GiorgioSW/godong/cabinet/doc/README.md

## Sub Folder ini berisikan dokumentasi hardware dari panel Godong
- skema/board di desain menggunakan autodesk eagle (v9 keatas)
- terdapat file PDF untuk skema/board dan keterangannya, lihat `hardware/Godhong_Project_Documentation_FULL.pdf`

## TODO untuk hardware
- tds meter masih DIY, sehingga sangat tidak stabil. ada beberapa referensi hardware dipasaran(grafity) namun hanya dapat mengukur dari rentang ppm 0 hingga 1000 saja s(Godong memerlukan rentang 0-2000ppm). terdapat artikel yang cukup bagus untuk digunakan sebagai referensi desain TDS meter kedepannya 'https://thecavepearlproject.org/2017/08/12/measuring-electrical-conductivity-with-an-arduino-part1-overview/'
- kabel penghubung dari main board ke modul relay hanyalah kabel pelangi biasa, yang seharusnya kabel IDC 16x2. ganti ke kabel IDC bila sudah ada.
