GiorgioSW/godong/cabinet/doc/schematic/OUTPUT/Image/BoardKeteranganLengkap.png

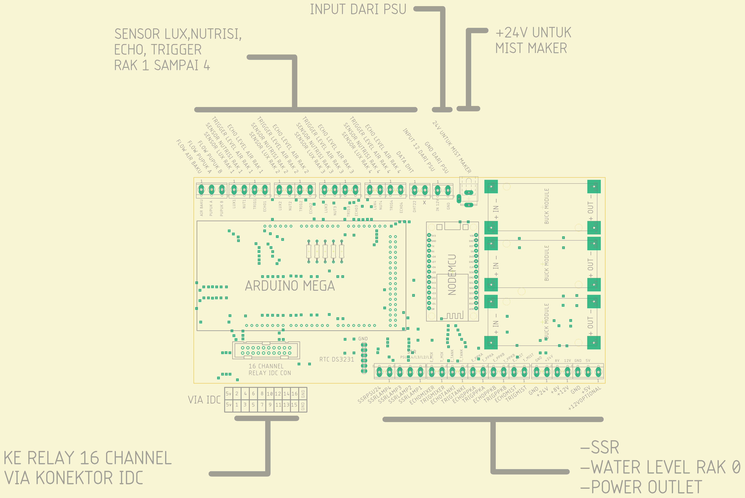
cabinet/doc/schematic/OUTPUT/Image/BoardKeteranganLengkap.png
