GiorgioSW/godong/cabinet/doc/schematic/OUTPUT/Image/BoardView.png

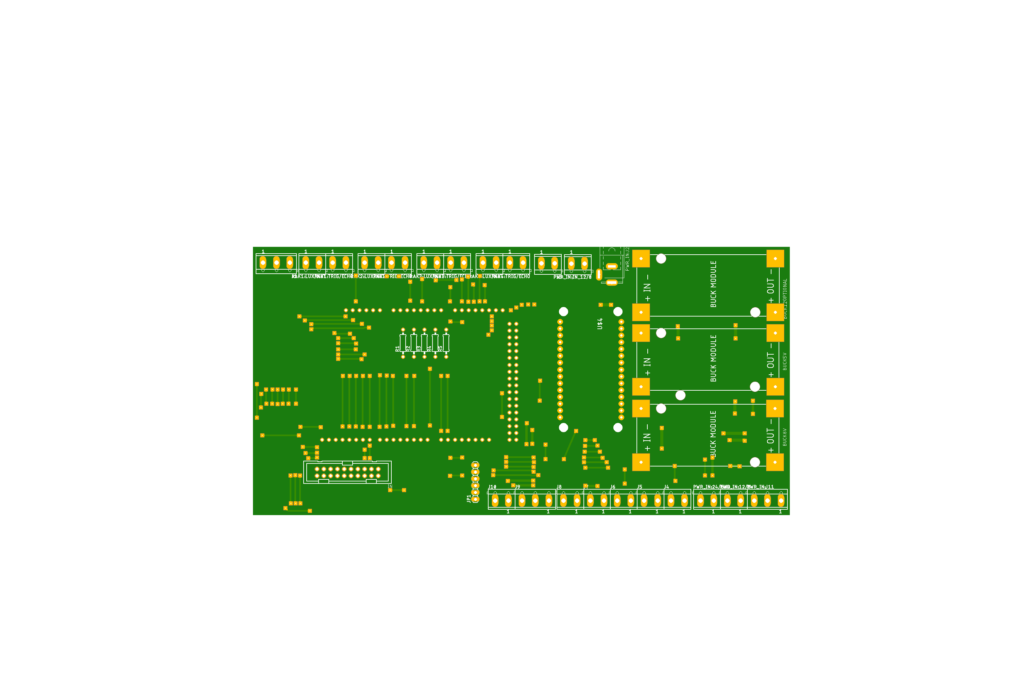
cabinet/doc/schematic/OUTPUT/Image/BoardView.png
