GiorgioSW/godong/cabinet/doc/hardware/Godhong_Project_Documentation_FULL.pdf

400.00

# TATA LETAK PANEL

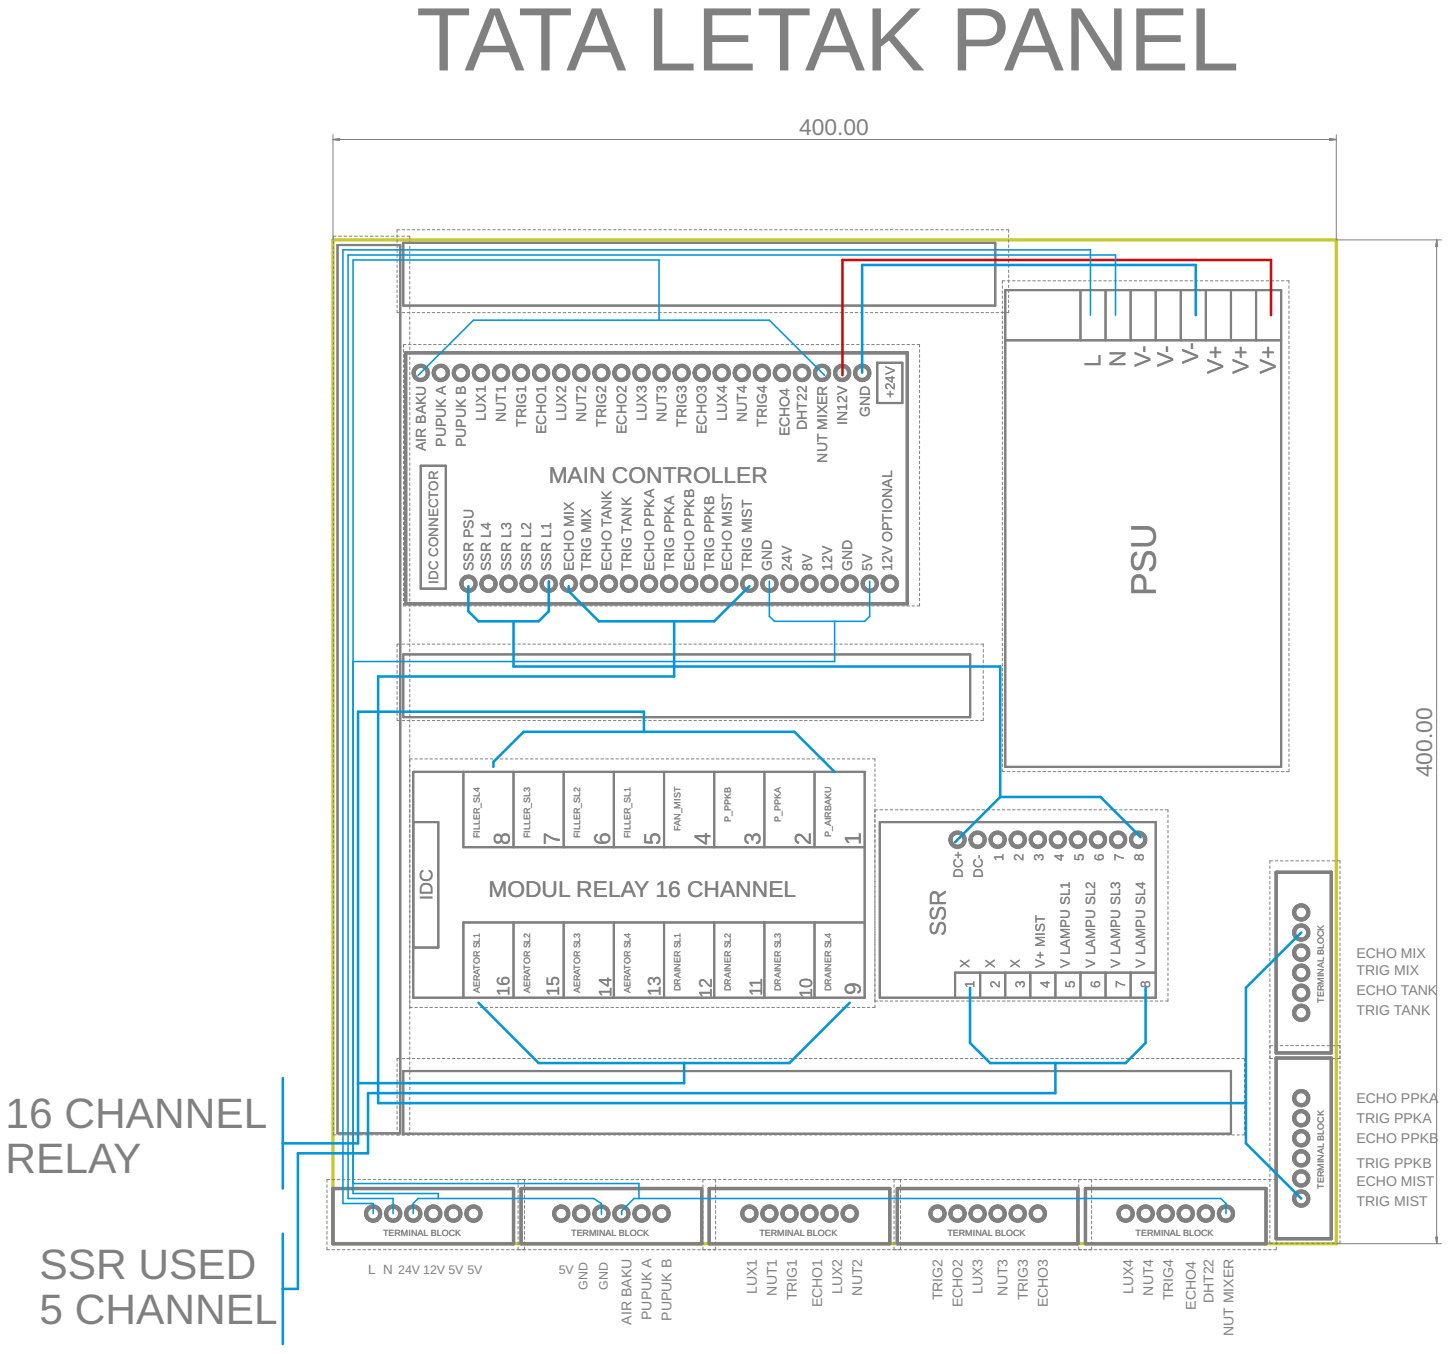
[picture p20: page 1]
TERMINAL BLOCK; MAIN CONTROLLER; AIR BAKU; PUPUK A; PUPUK B; LUX1 NUT1 TRIG1 ECHO1; LUX2 NUT2 TRIG2 ECHO2; LUX3 NUT3 TRIG3 ECHO3; LUX4 NUT4 TRIG4 ECHO4 DHT22 NUT MIXER; IN12V GND; SSR PSU; TRIG MIX; ECHO TANK; TRIG TANK; ECHO PPKA; TRIG PPKA; ECHO PPKB; TRIG PPKB; ECHO MIST; 12V GND; 12V OPTIONAL; IDC CONNECTOR; IDC; P_AIRBAKU; P_PPKA; P_PPKB; FAN_MIST; FILLER_SL1; FILLER_SL2; FILLER_SL3; FILLER_SL4; AERATOR SL4; AERATOR SL3; AERATOR SL2; AERATOR SL1; GND; TRIG PPKB ECHO MIST; 16 CHANNEL RELAY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

SSR L4 SSR L3 SSR L2 SSR L1 ECHO MIX

SSR L4 SSR L3 SSR L1 ECHO MIX

TRIG MIST GND

8 V LAMPU SL4 V LAMPU SL3 V LAMPU SL2 V LAMPU SL1 V+ MIST

MODUL RELAY 16 CHANNEL

DUL RELAY 16 CHANNEL

DRAINER SL4 DRAINER SL3 DRAINER SL2 DRAINER SL1

TERMINAL BLOCK ECHO MIX

TERMINAL BLOCK

TRIG MIST GN

# WATER LEVEL ULTRASONIC

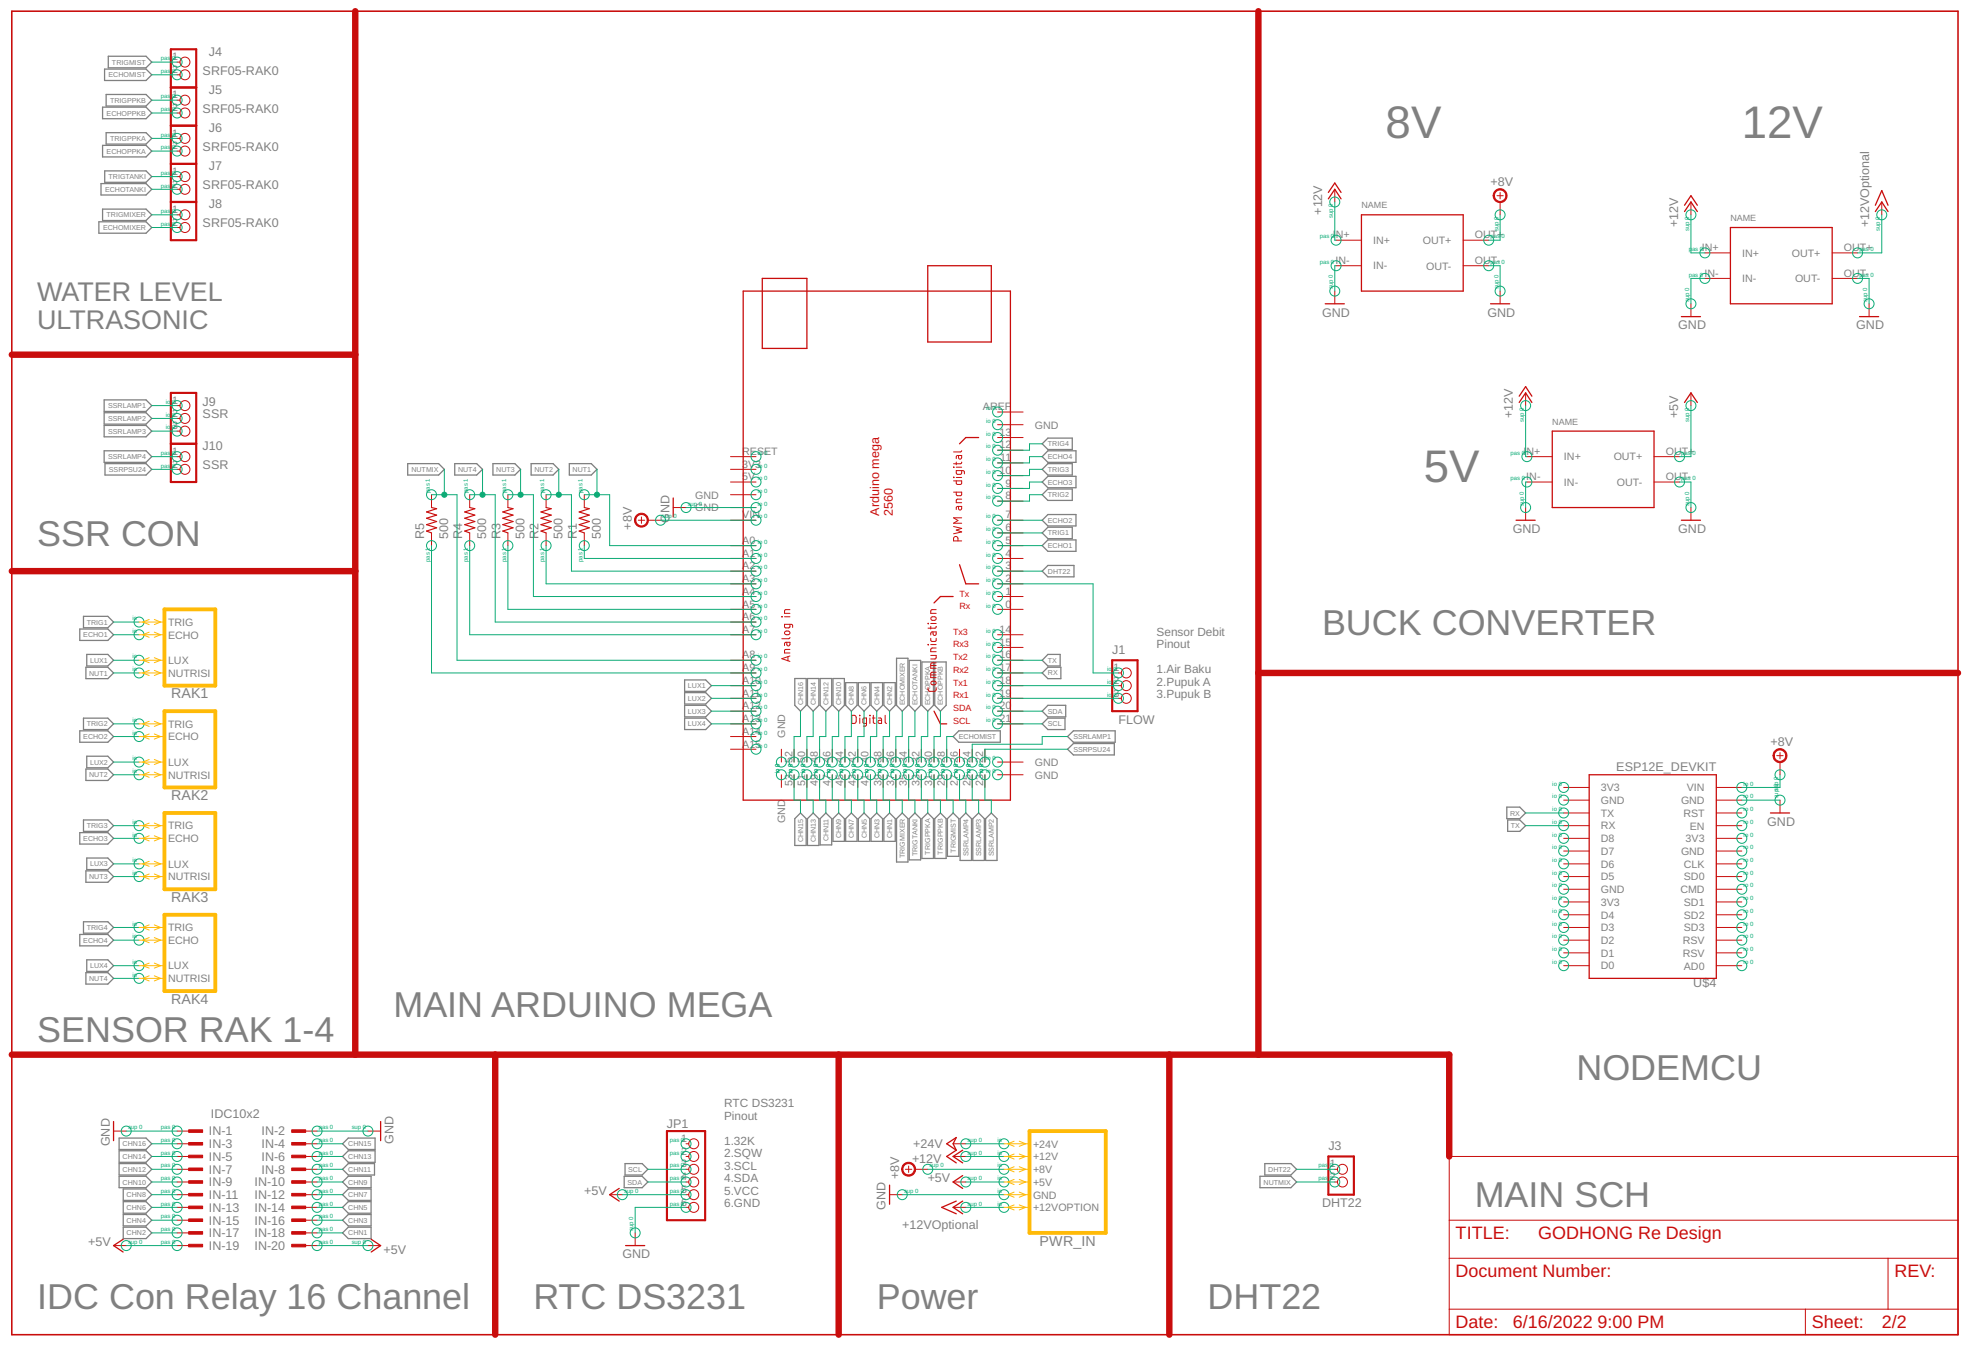
[picture p21: page 2]

Sensor Debit Pinout 1.Air Baku

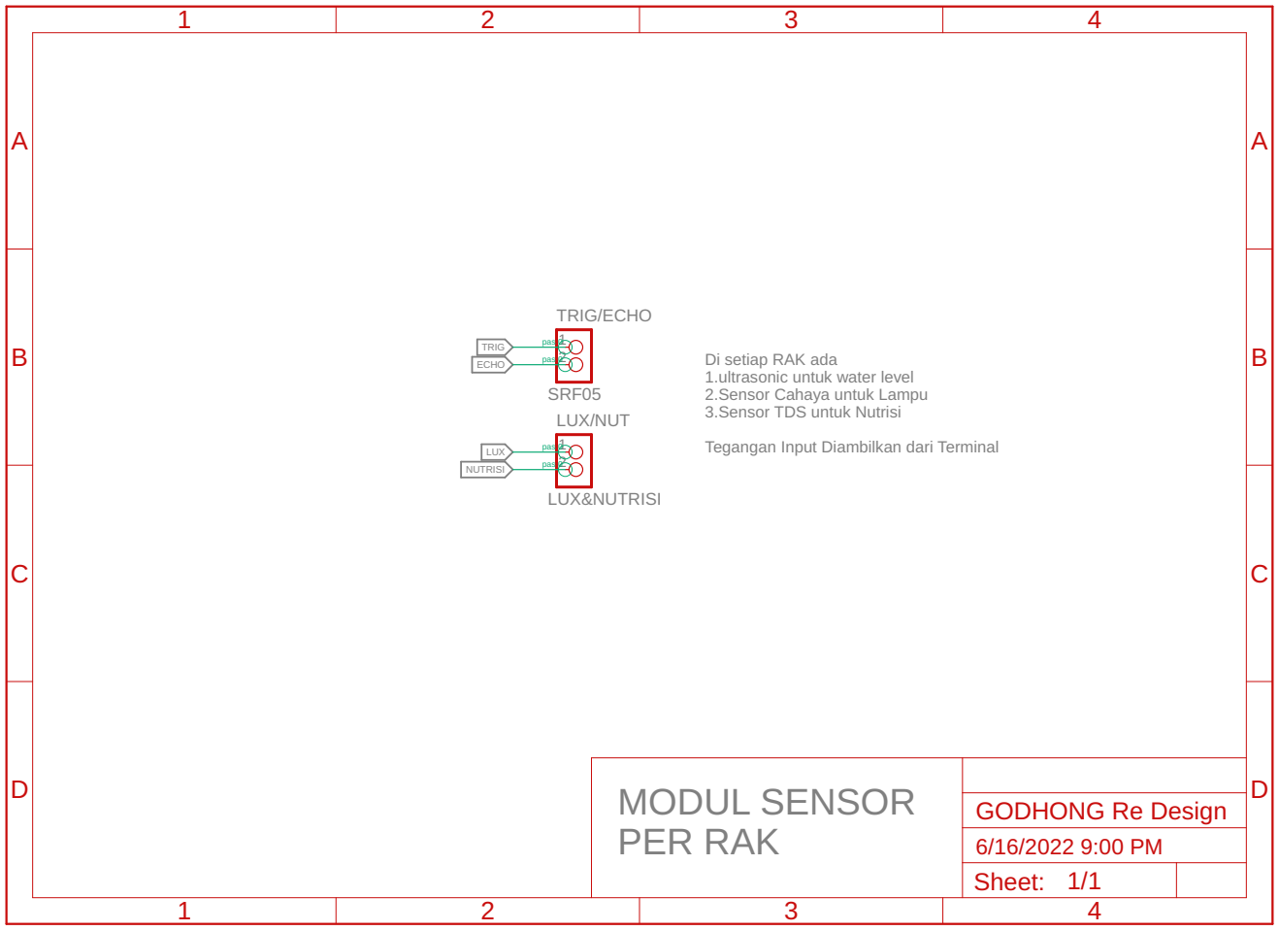
[picture p22: figure]
Di setiap RAK ada 1.ultrasonic untuk water level 2.Sensor Cahaya untuk Lampu 3.Sensor TDS untuk Nutrisi; Tegangan Input Diambilkan dari Terminal; MODUL SENSOR PER RAK; SRF05; LUX&NUTRISI; 2TRIG/ECHO; 2LUX/NUT; TRIG; ECHO; LUX NUTRISI; Sheet: 1/1; GODHONG Re Design; pas

1 | 2 | 3 | 4

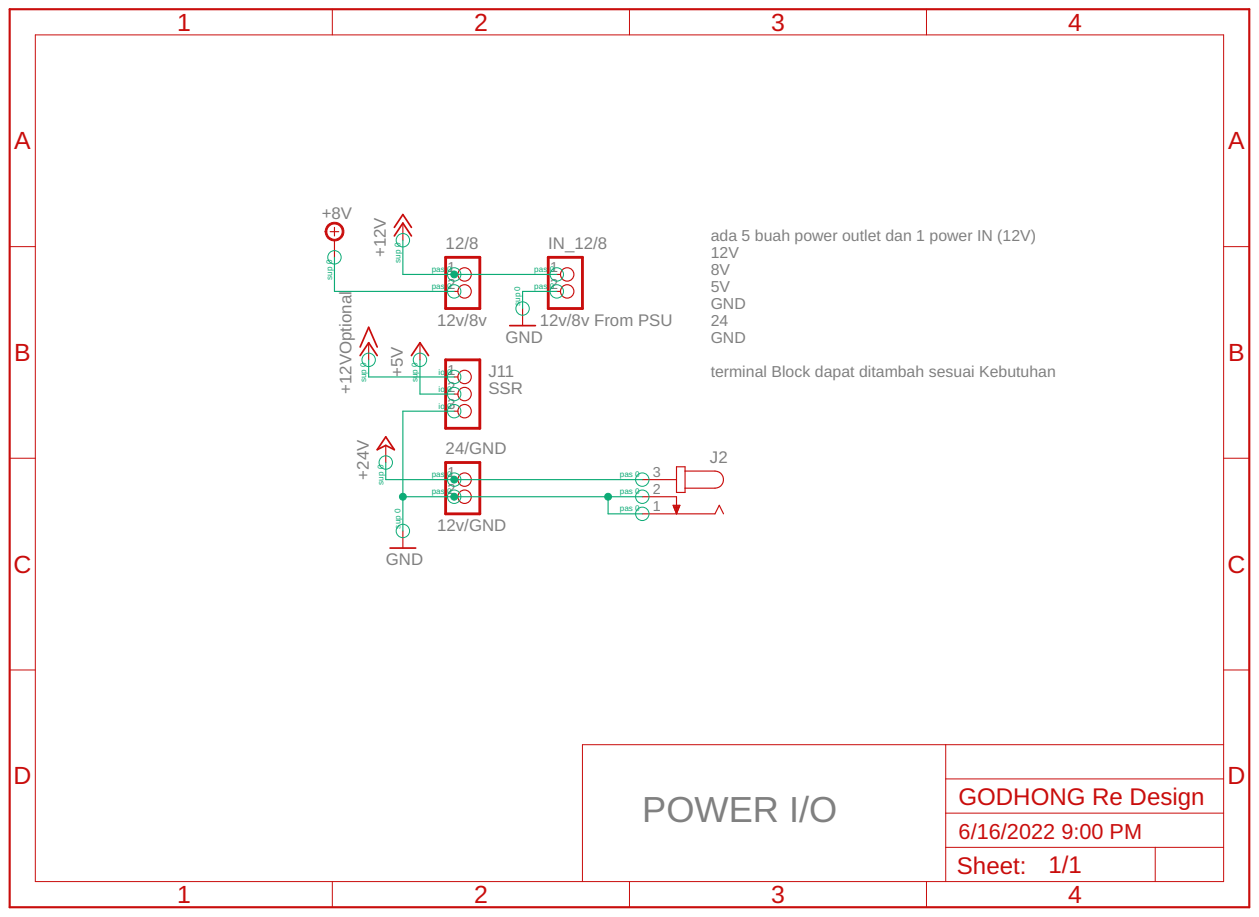
[picture p23: page 4]
ada 5 buah power outlet dan 1 power IN (12V) 12V 8V 5V GND 24 GND; 12v/8v ⁺¹²V; GND; 12v/GND; 12v/8v From PSU GND; +SSR; Optional 1; 224/GND; pas; sup 0; pas 0

terminal Block dapat ditambah sesuai Kebutuhan

GODHONG Re Design

POWER I/O

Sheet: 1/1

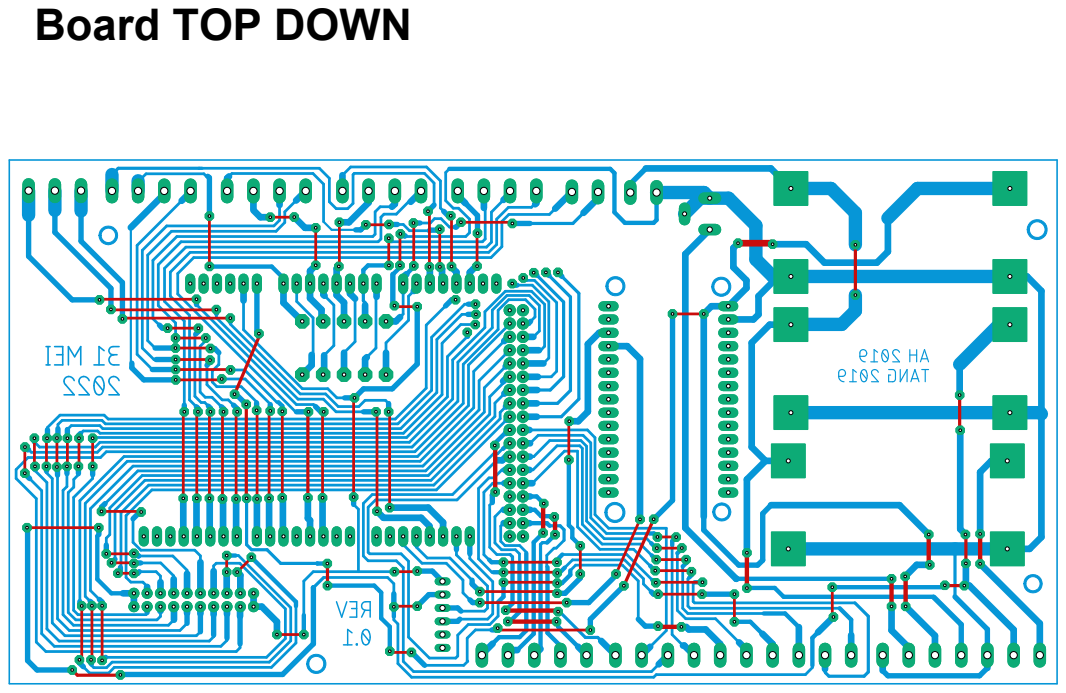
[picture p24: page 5]

Board TOP DOWN

# Board Detail

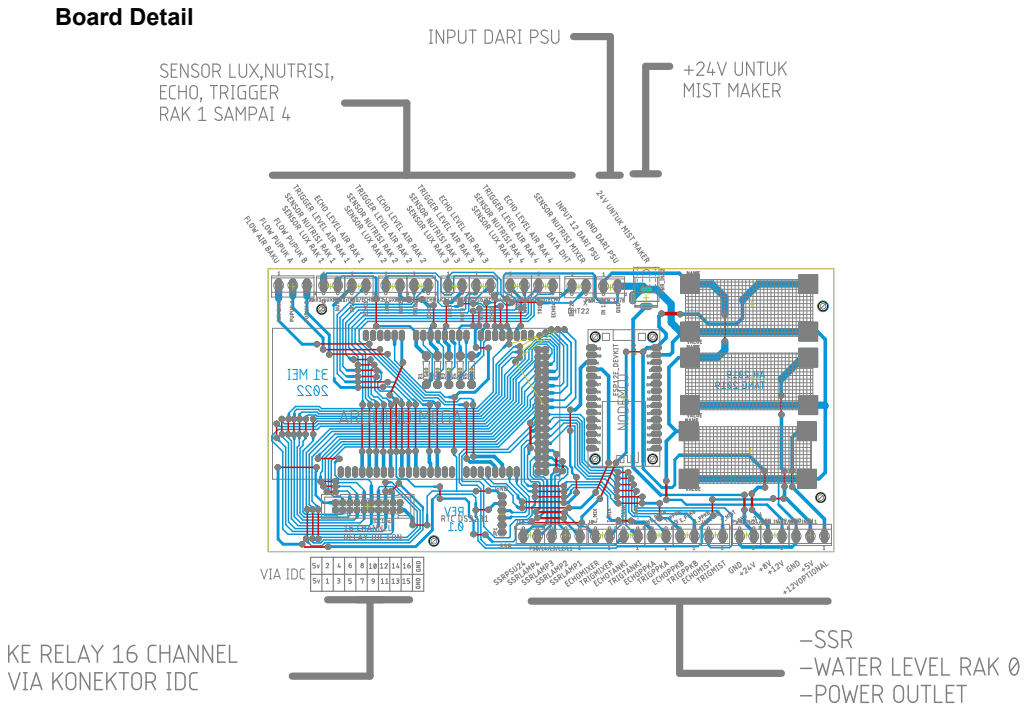
[picture p25: page 6]

# Jalur Rangkaian

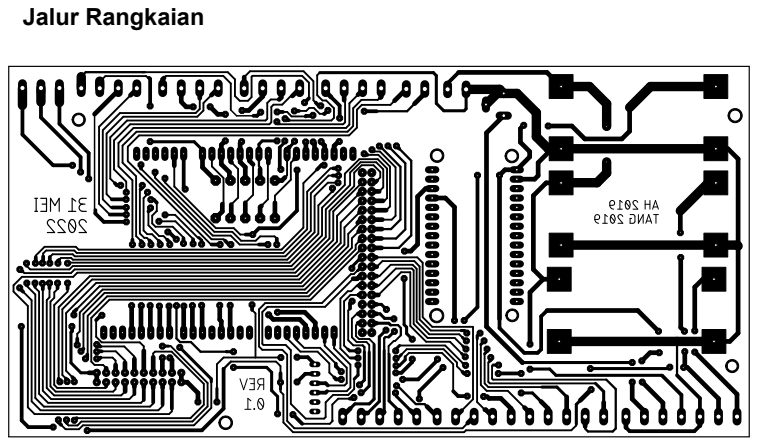
[picture p26: page 7]

# Silk Screen

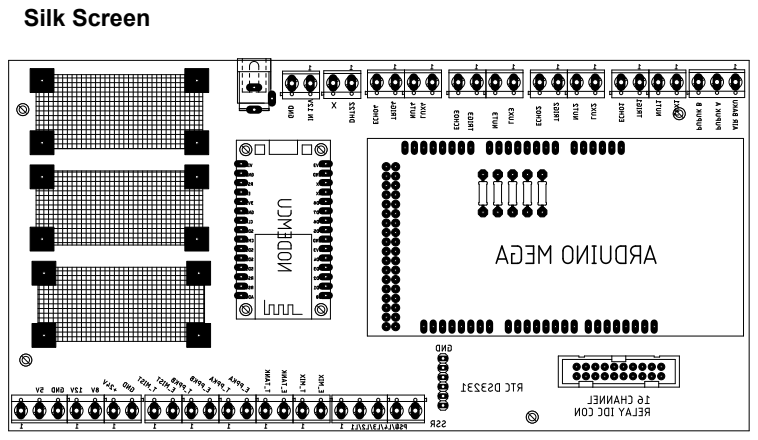
[picture p27: page 8]
