GiorgioSW/godong/cabinet/doc/schematic/OUTPUT/PDF/Godhong_Project_Documentation.pdf

SSR L4 SSR L3 SSR L2 SSR L1 ECHO MIX

SSR L4 SSR L3 SSR L1 ECHO MIX

8 V LAMPU SL4 V LAMPU SL3 V LAMPU SL2 V LAMPU SL1 V+ MIST

DRAINER SL4 DRAINER SL3 DRAINER SL2 DRAINER SL1

TERMINAL BLOCK ECHO MIX

TERMINAL BLOCK


Sensor Debit Pinout 1.Air Baku

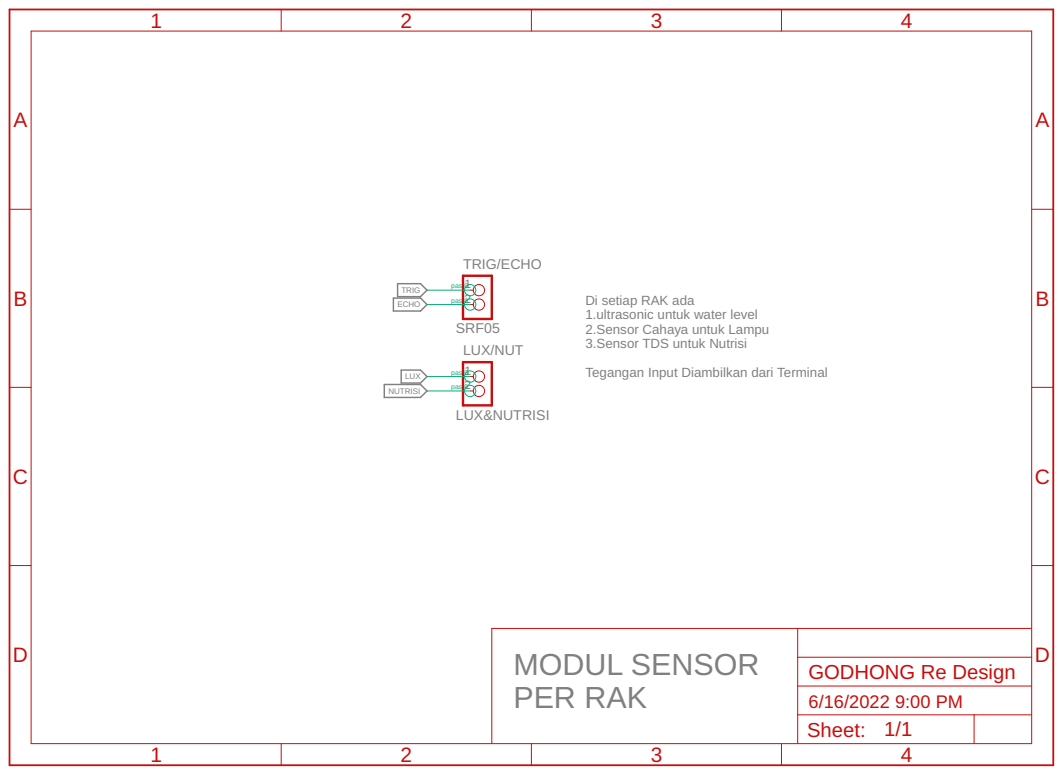
[picture p28: page 3]
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

Tegangan Input Diambilkan dari Terminal

MODUL SENSOR PER RAK

Sheet: 1/1


terminal Block dapat ditambah sesuai Kebutuhan

POWER I/O

Sheet: 1/1
