GiorgioSW/godong/cabinet/doc/schematic/OUTPUT/PDF/Godong Schematic.pdf

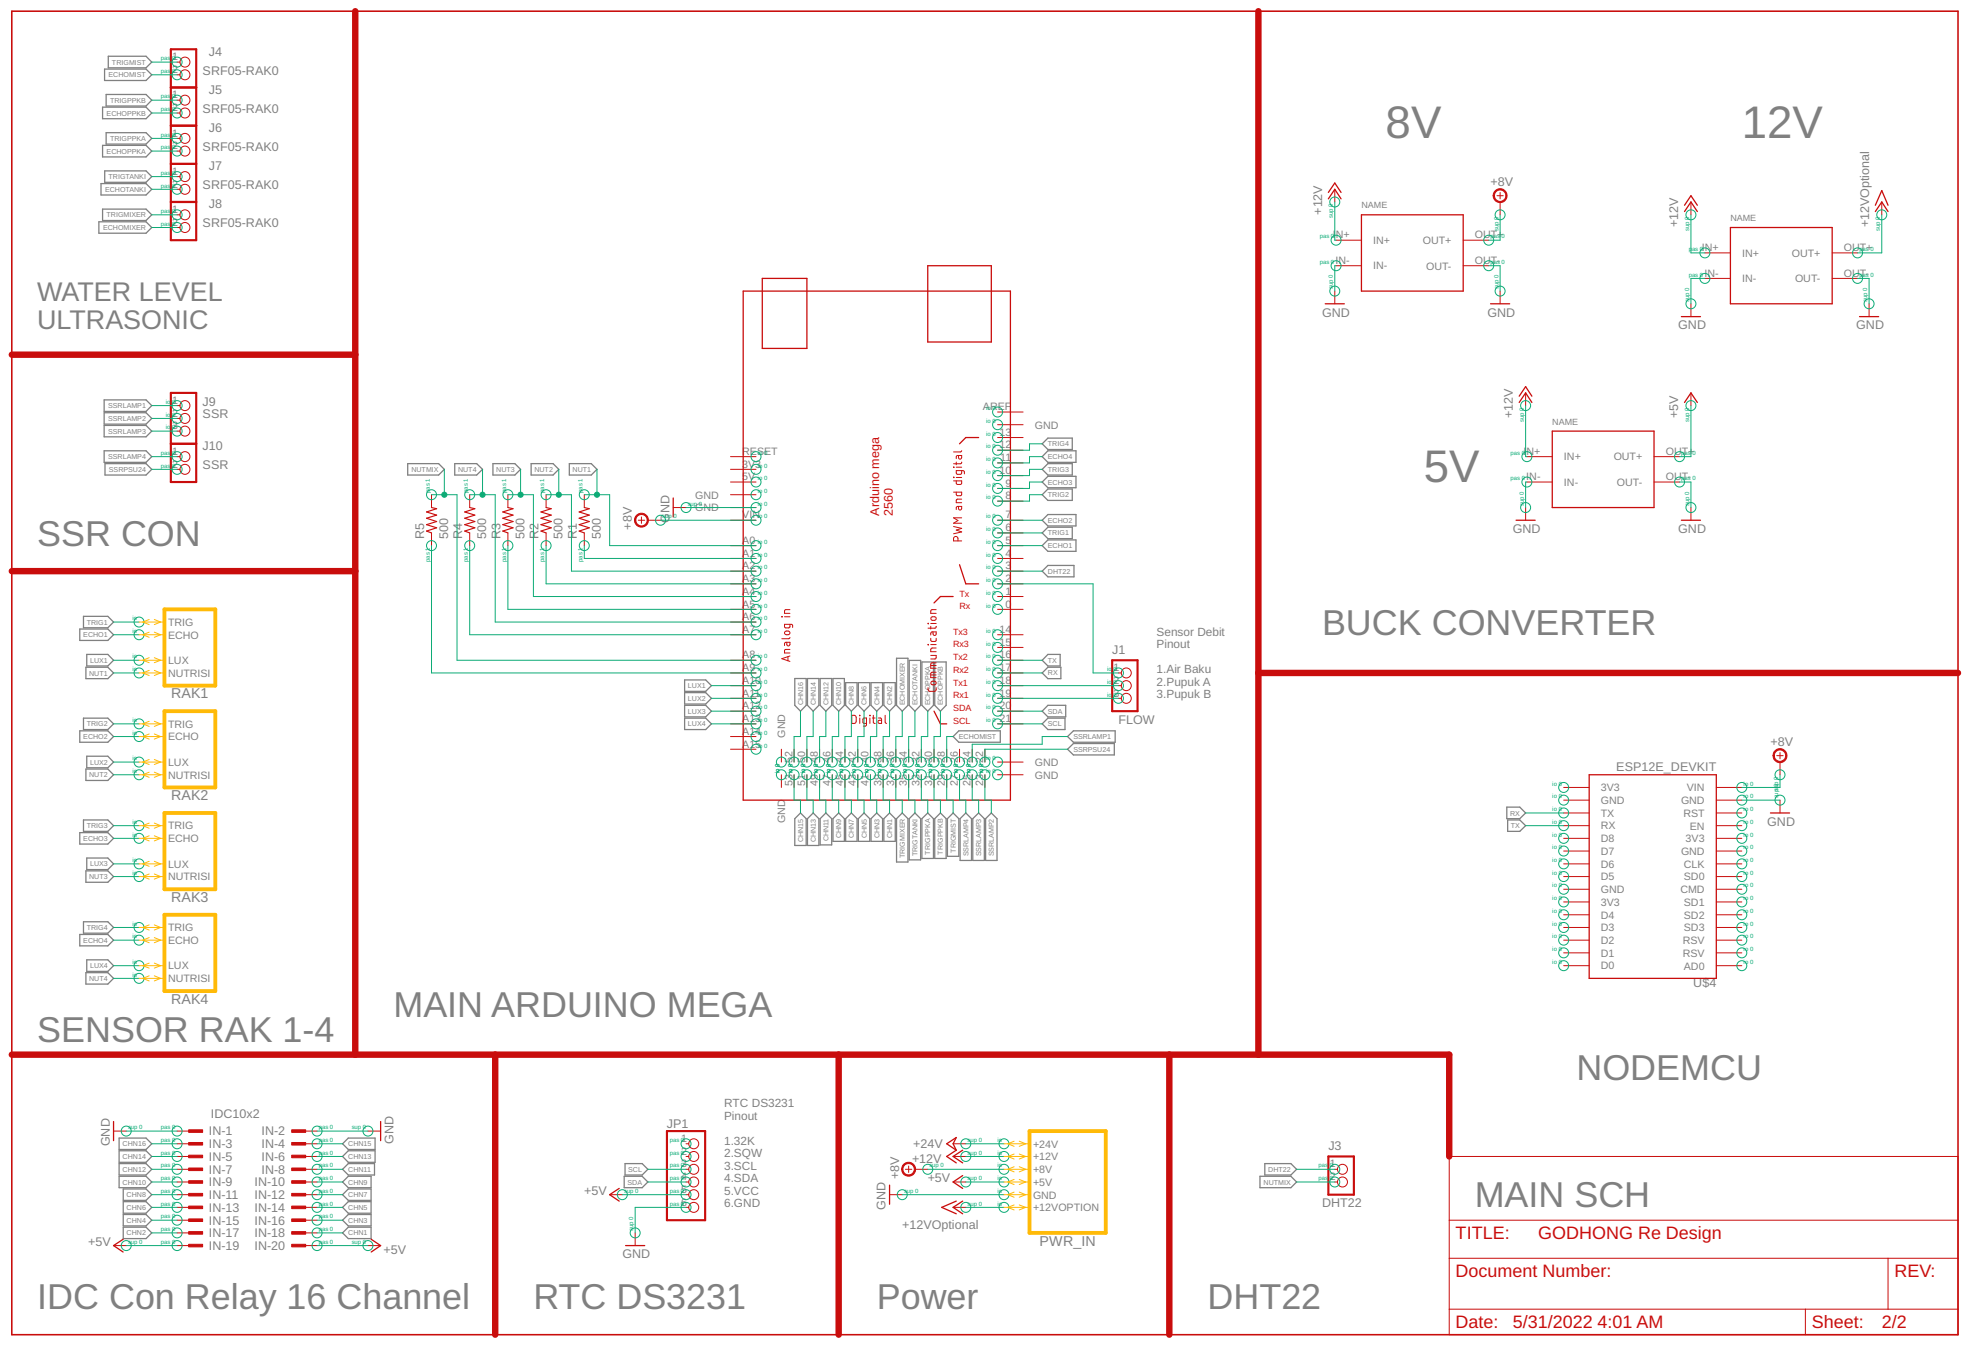
[picture p29: page 2]

Sensor Debit Pinout 1.Air Baku

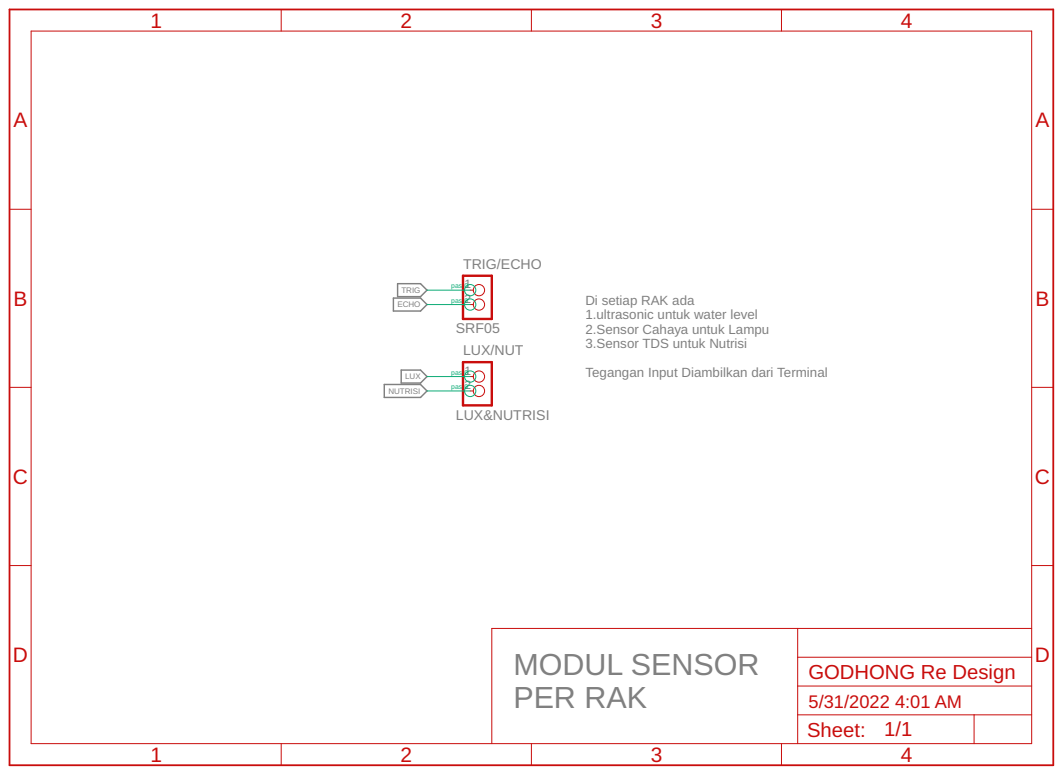
[picture p30: page 3]

Di setiap RAK ada
1.ultrasonic untuk water level
2.Sensor Cahaya untuk Lampu
3.Sensor TDS untuk Nutrisi

Tegangan Input Diambilkan dari Terminal

MODUL SENSOR PER RAK

Sheet: 1/1

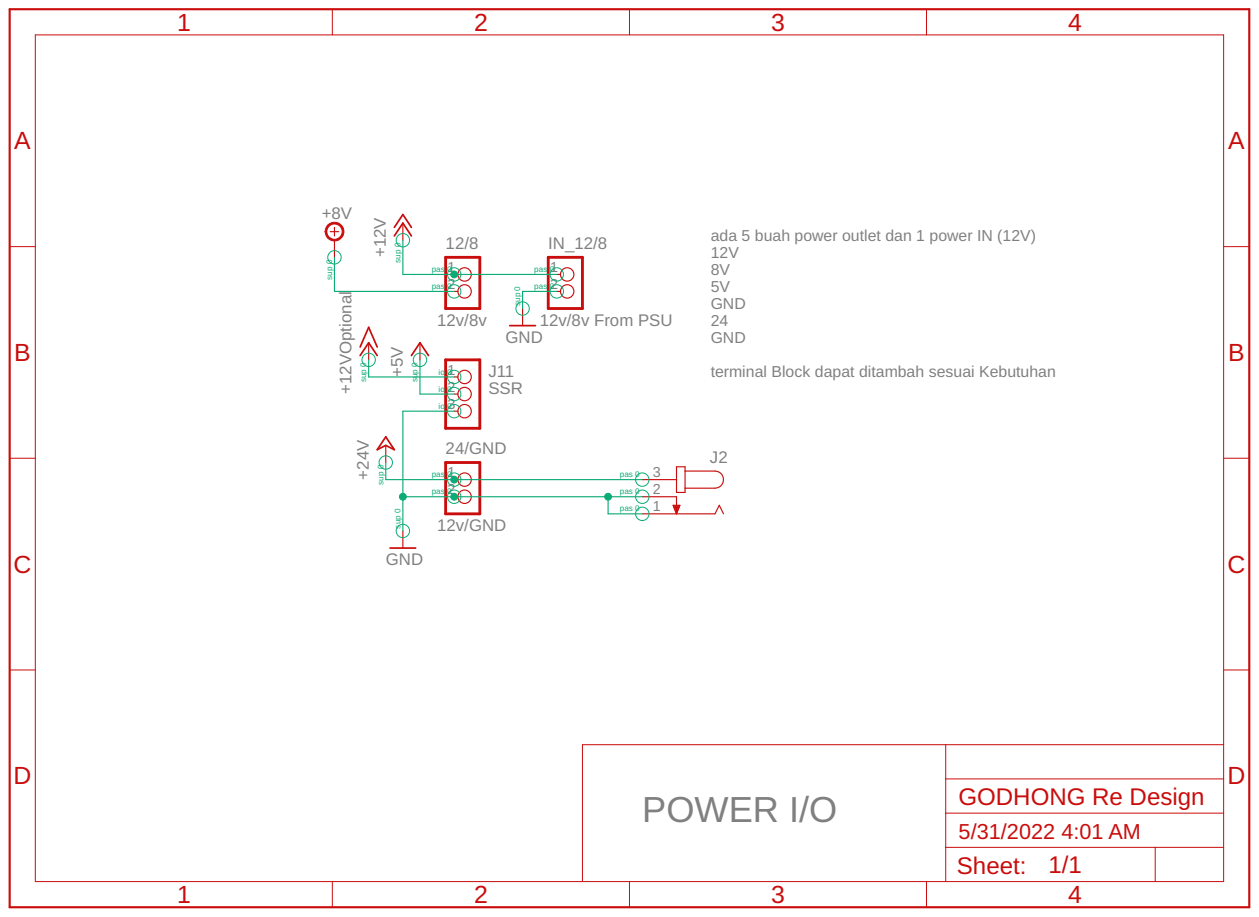
[picture p31: page 4]

terminal Block dapat ditambah sesuai Kebutuhan

POWER I/O

Sheet: 1/1
