GiorgioSW/godong/cabinet/doc/schematic/OUTPUT/PDF/Godong Board Top Down.pdf

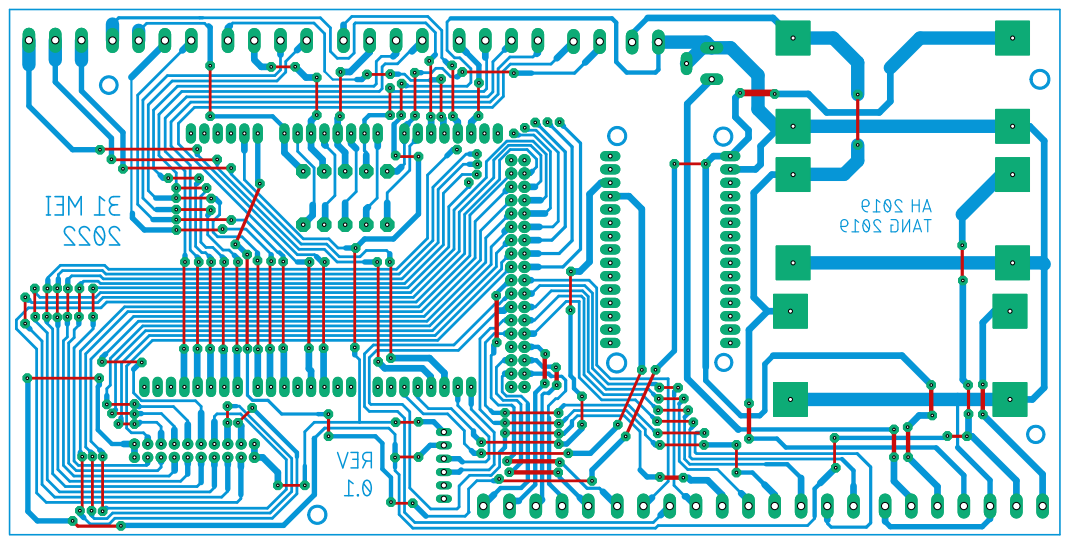
[picture p32: page 1]
