GiorgioSW/godong/cabinet/doc/schematic/OUTPUT/PDF/Godong Keterangan Lengkap.pdf

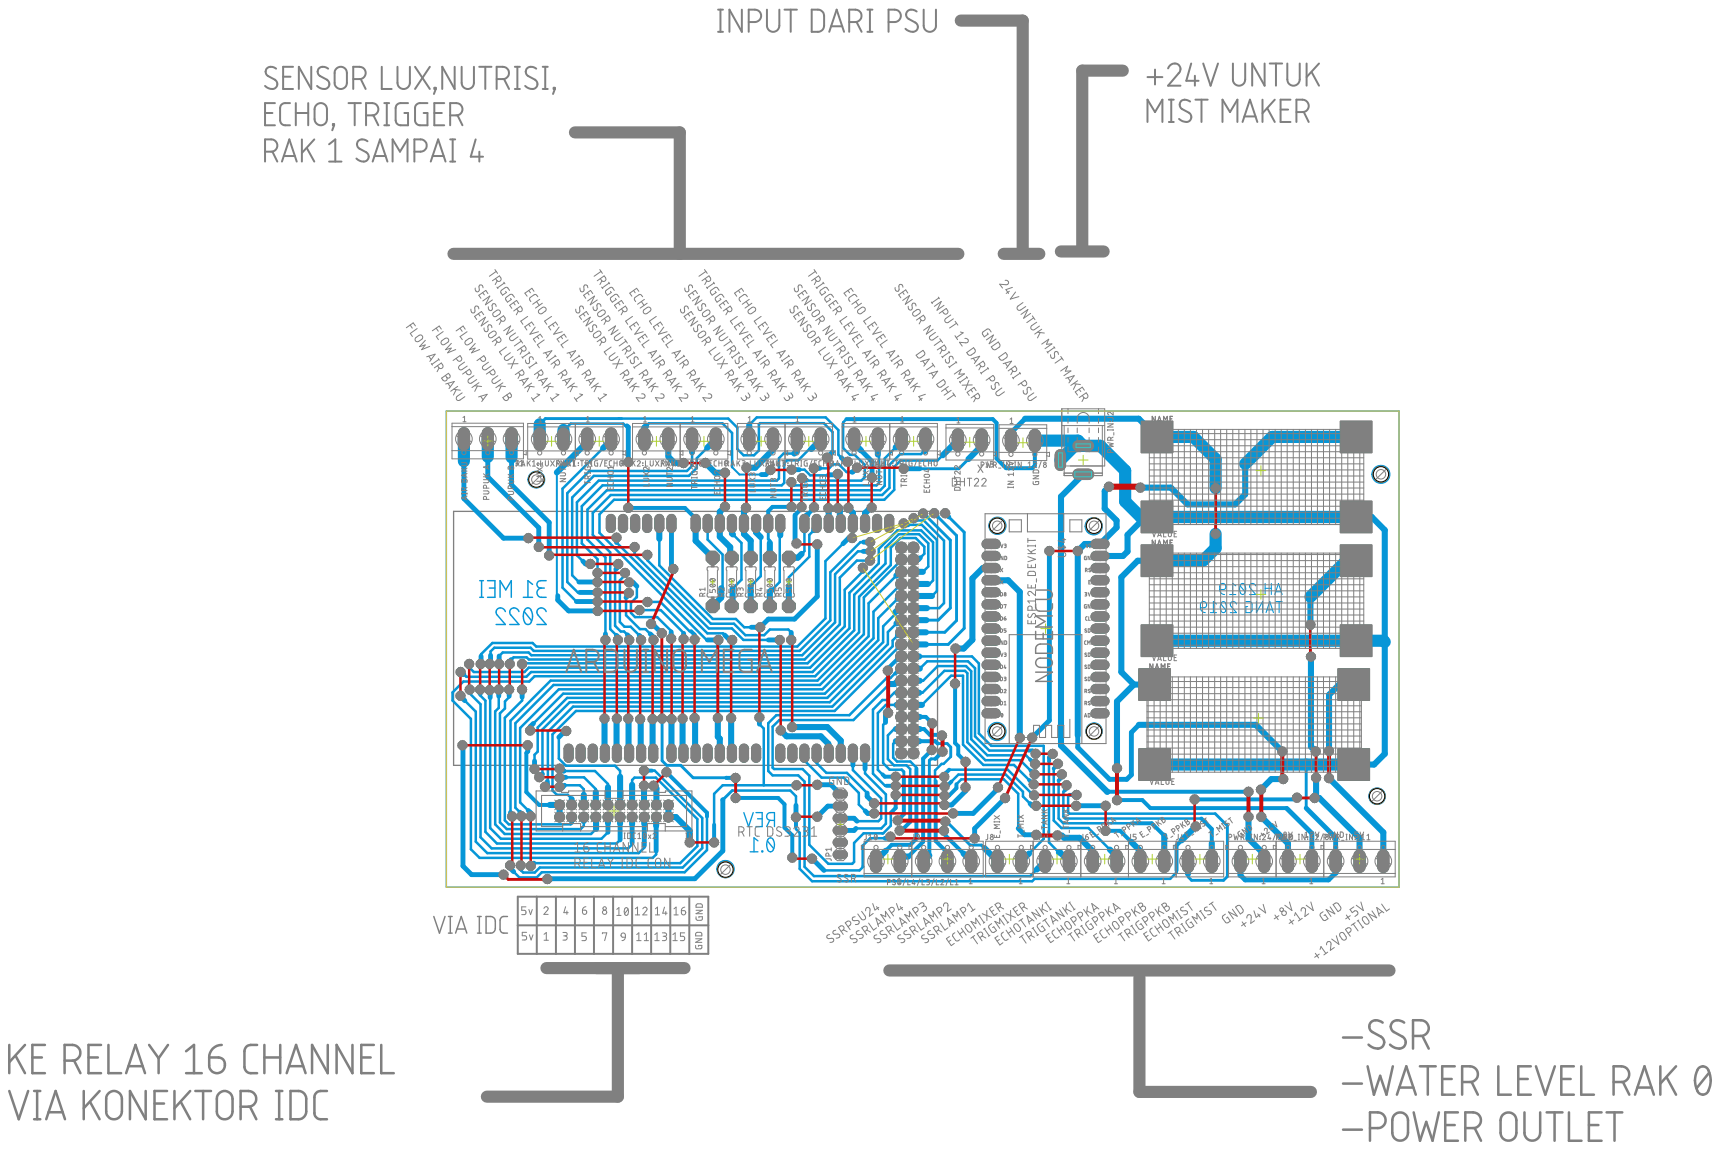
[picture p33: page 1]
