GiorgioSW/godong/cabinet/doc/schematic/OUTPUT/PDF/JALUR PCB - GODHONG Re Design.pdf

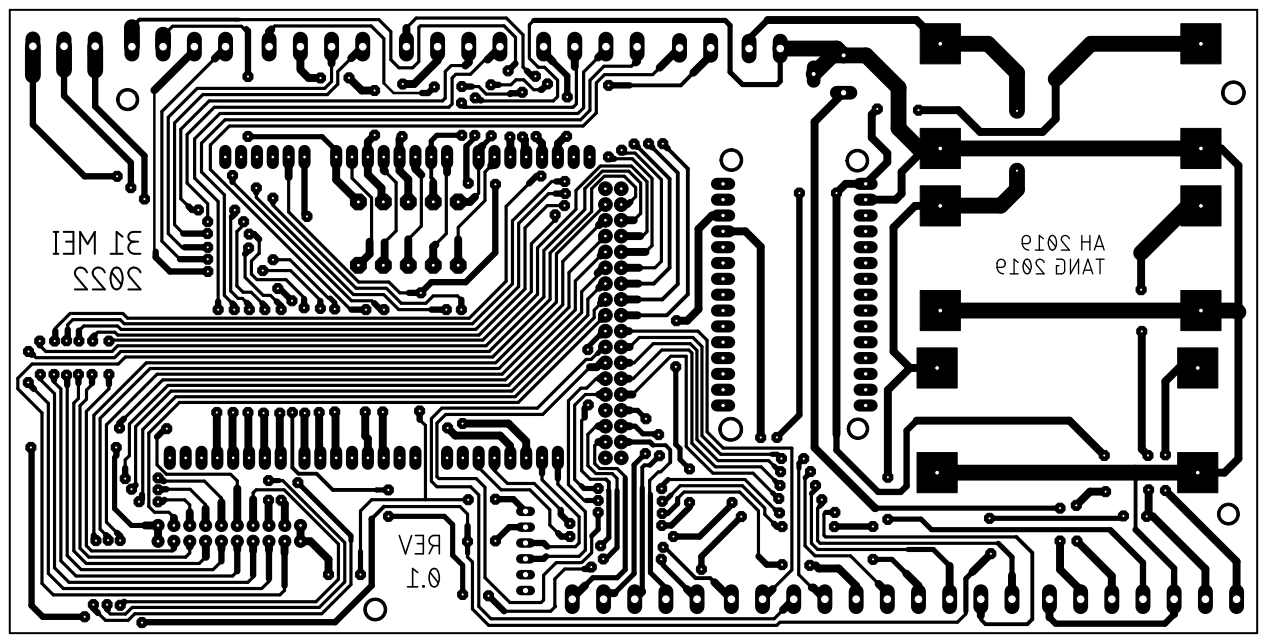
[picture p34: page 1]
