GiorgioSW/godong/cabinet/doc/schematic/OUTPUT/PDF/Silk Screen - GODHONG Re Design.pdf

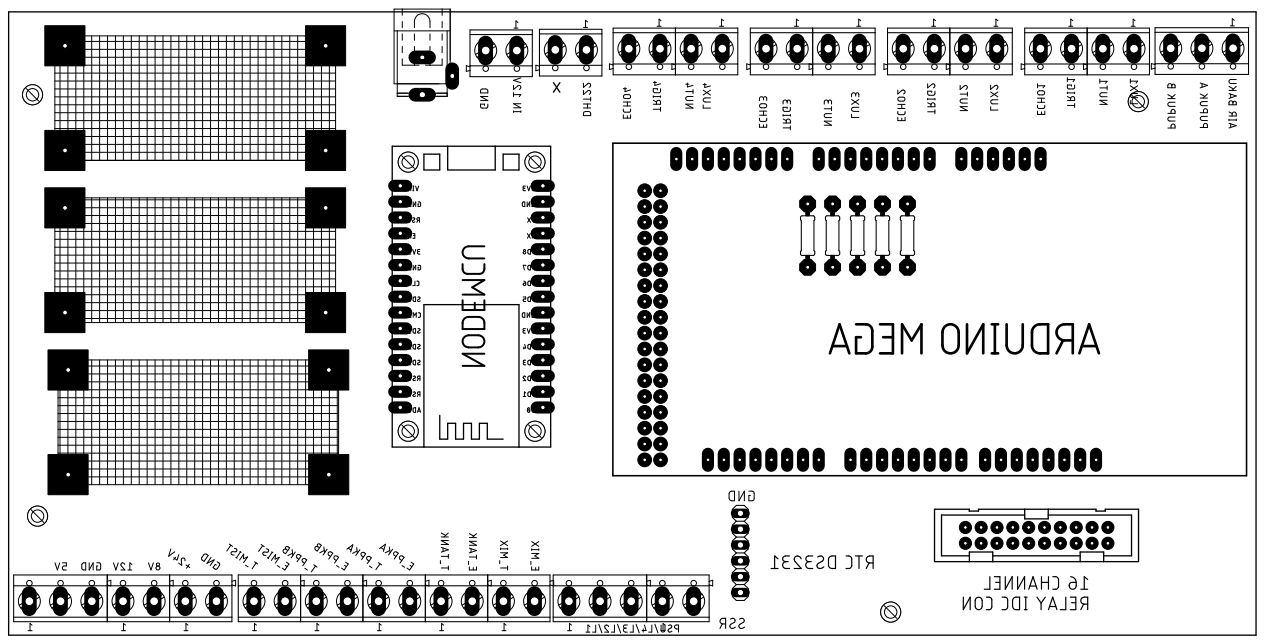
[picture p35: page 1]
