GiorgioSW/godong/cabinet/doc/schematic/GODHONG Re Design.brd

## EAGLE design cabinet/doc/schematic/GODHONG Re Design.brd (2022-09-20)

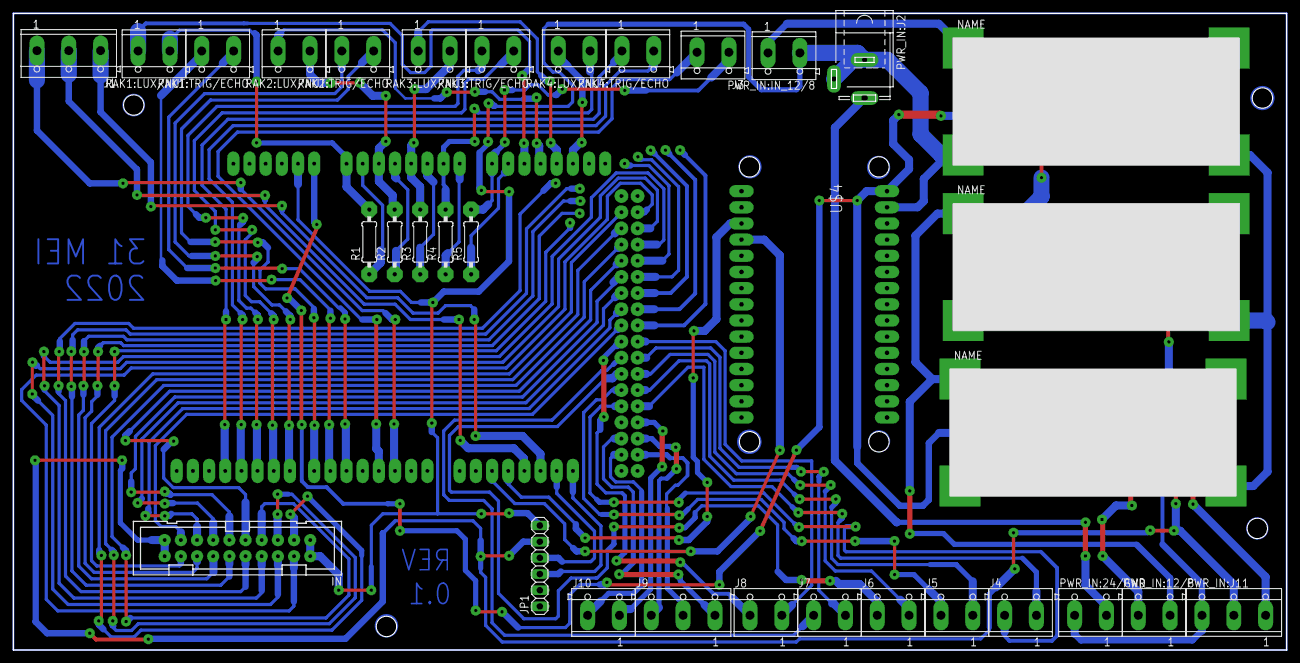
[picture p36: board GODHONG Re Design.brd from above]

Board: 2 copper layers, 200.0 x 100.0 mm, 34 parts (1 on the bottom side), 67 nets.

Parts:
5V: 5V; CP8-ADJ
8V: 8V; CP8-ADJ
12OPTION: 12Option; CP8-ADJ
IN: IDC10x2; PAK100/2500-20
J1, J9: Debit; TERMINAL_BLOCK_3P_5
J3, J4, J5, J6, J7, J8, J10: SRF05; TERMINAL_BLOCK_2P_5
JP1: 1X06
PWR_IN:12/8, PWR_IN:24/GND: SRF05; TERMINAL_BLOCK_2P_5
PWR_IN:IN_12/8: SRF05; TERMINAL_BLOCK_2P_5
PWR_IN:J2: SPC4078
PWR_IN:J11: Debit; TERMINAL_BLOCK_3P_5
R1, R2, R3, R4, R5: 500; 0207/10
RAK1:LUX/NUT, RAK1:TRIG/ECHO, RAK2:LUX/NUT, RAK2:TRIG/ECHO, RAK3:LUX/NUT, RAK3:TRIG/ECHO, RAK4:LUX/NUT, RAK4:TRIG/ECHO: SRF05; TERMINAL_BLOCK_2P_5
U$1: MEGA_DEVICE; MEGAOUTLINE
U$4: ESP12E_DEVKIT

Connections:
+5V: 5V.OUT+, IN.19, IN.20, JP1.5, PWR_IN:J11.2
+8V: 8V.OUT+, PWR_IN:12/8.2, U$1.VIN, U$4.VIN
+12V: 5V.IN+, 8V.IN+, 12OPTION.IN+, PWR_IN:12/8.1, PWR_IN:IN_12/8.1
+15V: 12OPTION.OUT+, PWR_IN:J11.1
+24V: PWR_IN:24/GND.1, PWR_IN:J2.3
CHN1: IN.18, U$1.39
CHN2: IN.17, U$1.38
CHN3: IN.16, U$1.41
CHN4: IN.15, U$1.40
CHN5: IN.14, U$1.43
CHN6: IN.13, U$1.42
CHN7: IN.12, U$1.45
CHN8: IN.11, U$1.44
CHN9: IN.10, U$1.47
CHN10: IN.9, U$1.46
CHN11: IN.8, U$1.49
CHN12: IN.7, U$1.48
CHN13: IN.6, U$1.51
CHN14: IN.5, U$1.50
CHN15: IN.4, U$1.53
CHN16: IN.3, U$1.52
DHT22: J3.1, U$1.3
ECHO1: RAK1:TRIG/ECHO.2, U$1.5
ECHO2: RAK2:TRIG/ECHO.2, U$1.7
ECHO3: RAK3:TRIG/ECHO.2, U$1.9
ECHO4: RAK4:TRIG/ECHO.2, U$1.11
ECHOMIST: J4.2, U$1.28
ECHOMIXER: J8.2, U$1.36
ECHOPPKA: J6.2, U$1.32
ECHOPPKB: J5.2, U$1.30
ECHOTANKI: J7.2, U$1.34
FLOWAIRBAKU: J1.1, U$1.2
FLOWPPKA: J1.2, U$1.18
FLOWPPKB: J1.3, U$1.19
GND: 5V.IN-, 5V.OUT-, 8V.IN-, 8V.OUT-, 12OPTION.IN-, 12OPTION.OUT-, IN.1, IN.2, JP1.6, PWR_IN:24/GND.2, PWR_IN:IN_12/8.2, PWR_IN:J2.1, PWR_IN:J2.2, PWR_IN:J11.3, U$1.GND@3, U$4.GND@1
LUX1: RAK1:LUX/NUT.1, U$1.A10
LUX2: RAK2:LUX/NUT.1, U$1.A11
LUX3: RAK3:LUX/NUT.1, U$1.A12
LUX4: RAK4:LUX/NUT.1, U$1.A13
unnamed: R1.1, U$1.A1
unnamed: R2.1, U$1.A3
unnamed: R3.1, U$1.A5
unnamed: R4.1, U$1.A7
unnamed: R5.1, U$1.A9
NUT1: R1.2, RAK1:LUX/NUT.2, U$1.A0
NUT2: R2.2, RAK2:LUX/NUT.2, U$1.A2
NUT3: R3.2, RAK3:LUX/NUT.2, U$1.A4
NUT4: R4.2, RAK4:LUX/NUT.2, U$1.A6
NUTMIX: J3.2, R5.2, U$1.A8
RX: U$1.17, U$4.TX
SCL: JP1.3, U$1.21
SDA: JP1.4, U$1.20
SSRLAMP1: J9.1, U$1.24
SSRLAMP2: J9.2, U$1.23
SSRLAMP3: J9.3, U$1.25
SSRLAMP4: J10.1, U$1.27
SSRPSU24: J10.2, U$1.22
TRIG1: RAK1:TRIG/ECHO.1, U$1.6
TRIG2: RAK2:TRIG/ECHO.1, U$1.8
TRIG3: RAK3:TRIG/ECHO.1, U$1.10
TRIG4: RAK4:TRIG/ECHO.1, U$1.12
TRIGMIST: J4.1, U$1.29
TRIGMIXER: J8.1, U$1.37
TRIGPPKA: J6.1, U$1.33
TRIGPPKB: J5.1, U$1.31
TRIGTANKI: J7.1, U$1.35
TX: U$1.16, U$4.RX
